baimojushi/meditation-tent/v-2.0/interactive-visuals/visuals/live-action.jpg

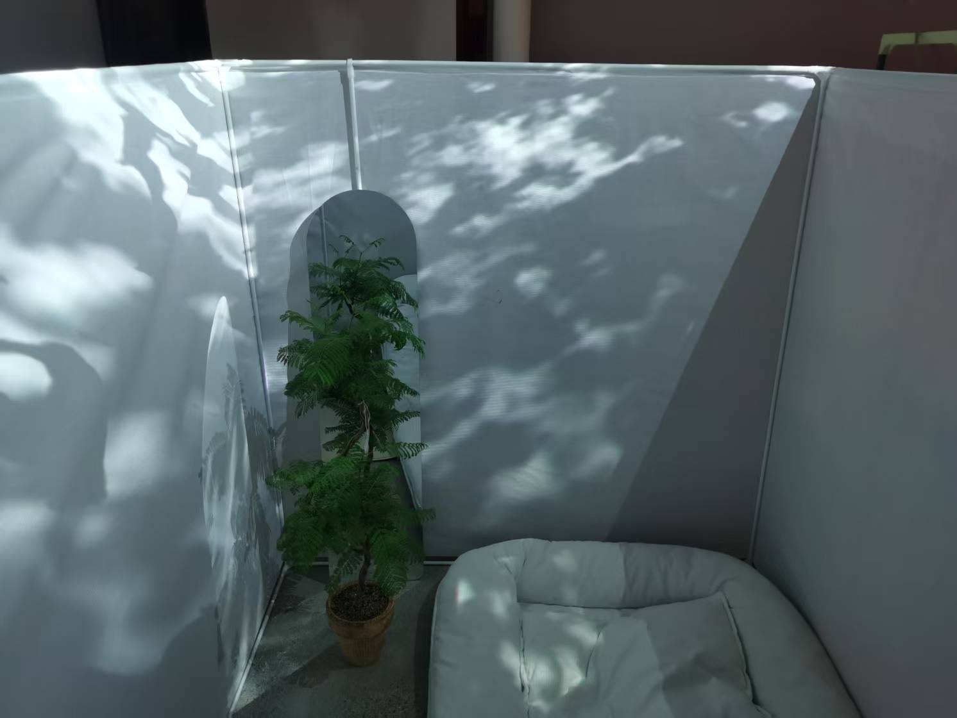
v-2.0/interactive-visuals/visuals/live-action.jpg
