baimojushi/meditation-tent/v-2.0/interactive-visuals/visuals/main-visualization.png

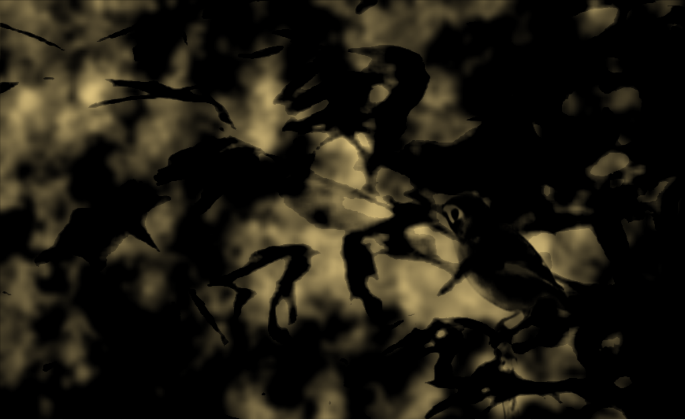
v-2.0/interactive-visuals/visuals/main-visualization.png
