baimojushi/meditation-tent/v-2.0/interactive-visuals/visuals/realistic-rendering.jpg

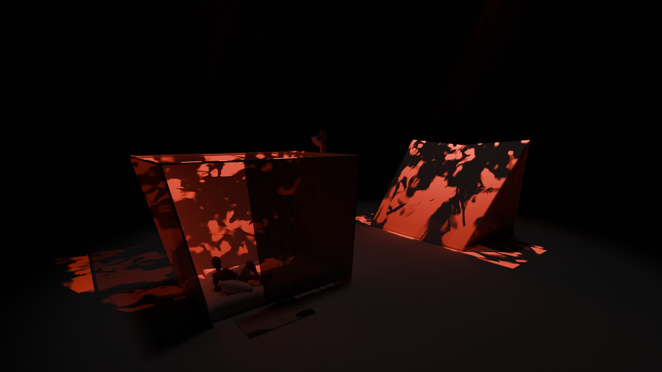
v-2.0/interactive-visuals/visuals/realistic-rendering.jpg
