baimojushi/meditation-tent/(commit log)

2026-03-06 初始提交
2026-03-06 迭代报告
